yashab248/WIRELESS_RC_CAR/finalElectricalArchitecture.png

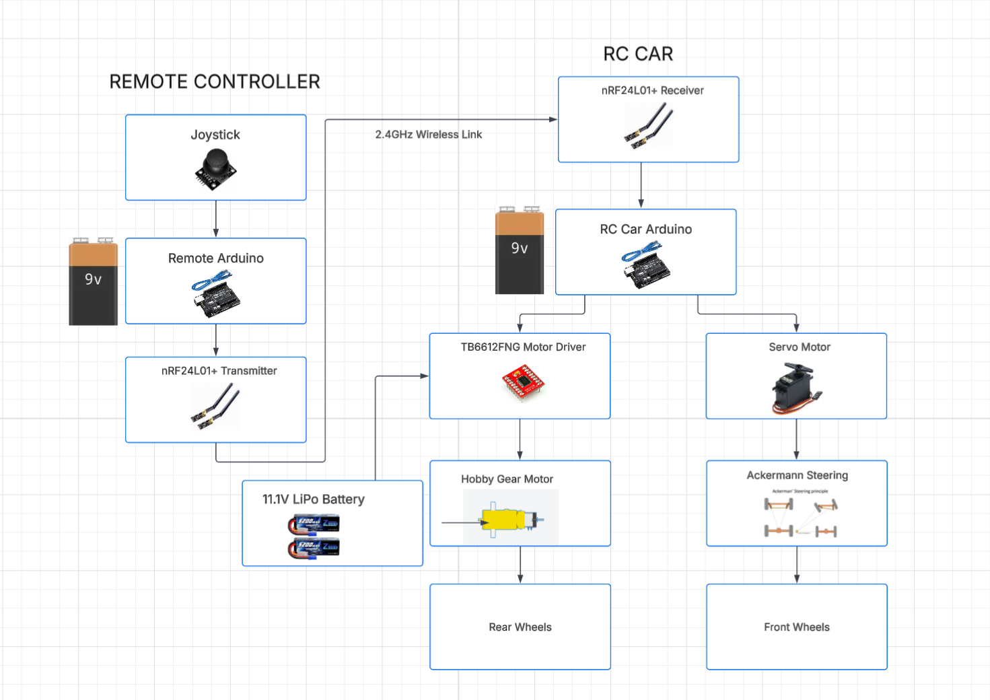
finalElectricalArchitecture.png
