yashab248/WIRELESS_RC_CAR/PROJECT-DEVELOPMENT-FLOWCHART.png

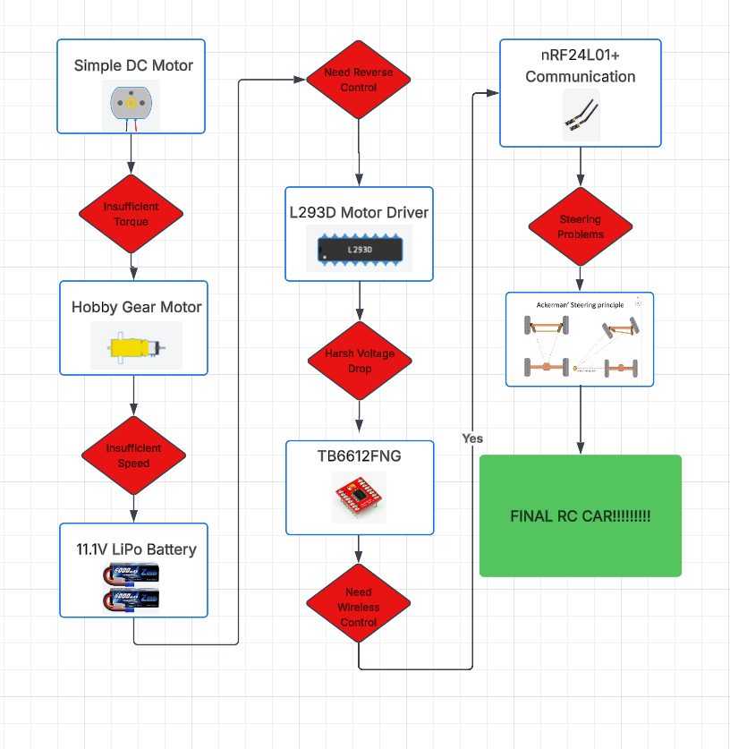
PROJECT-DEVELOPMENT-FLOWCHART.png
