yashab248/WIRELESS_RC_CAR/RC-CAR-L293D-CIRCUIT-SCHEMATIC.png

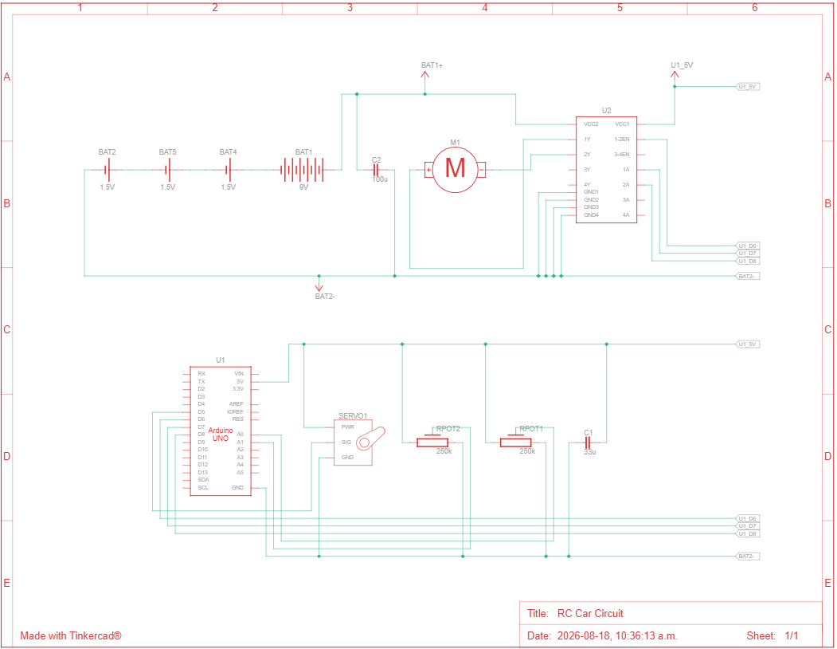
RC-CAR-L293D-CIRCUIT-SCHEMATIC.png
