yashab248/WIRELESS_RC_CAR/RC-CAR-L293D-CIRCUIT.png

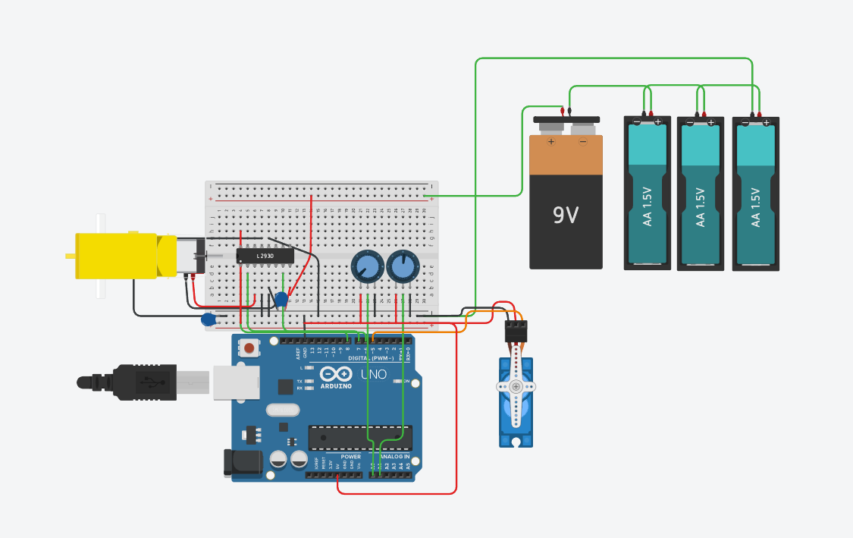
RC-CAR-L293D-CIRCUIT.png
