yashab248/WIRELESS_RC_CAR/RC-CAR-NPN-TRANSISTOR-CIRCUIT.png

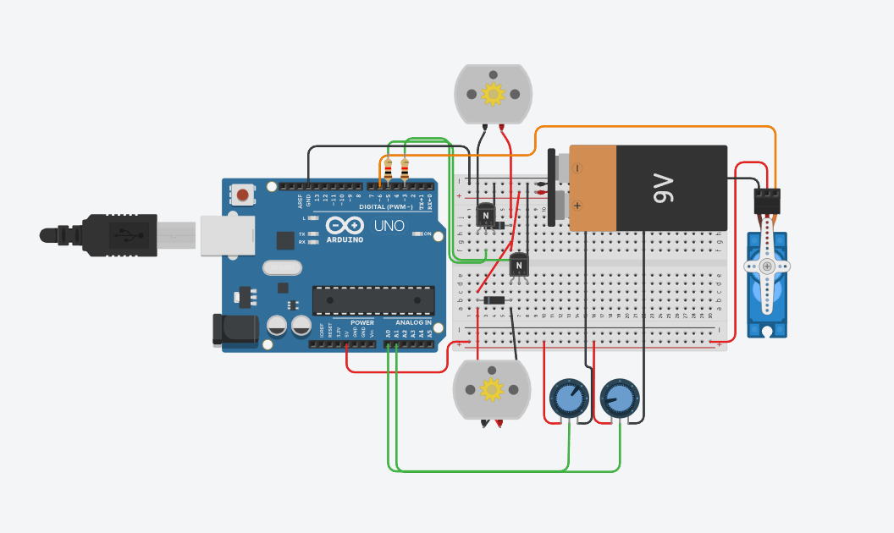
RC-CAR-NPN-TRANSISTOR-CIRCUIT.png
