yashab248/WIRELESS_RC_CAR/RC-CAR-NPN-TRANSISTOR-SCHEMATIC.png

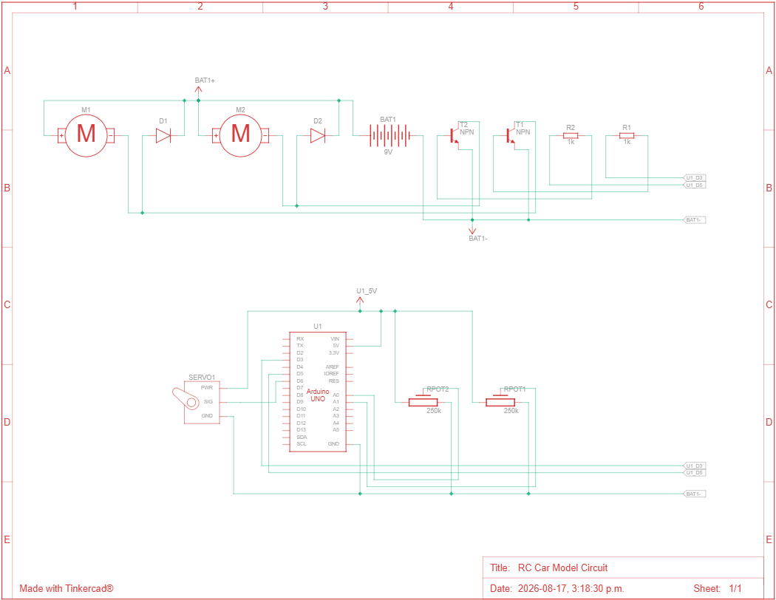
RC-CAR-NPN-TRANSISTOR-SCHEMATIC.png
