yashab248/WIRELESS_RC_CAR/RECEIVER-CIRCUIT-SCHEMATIC.png

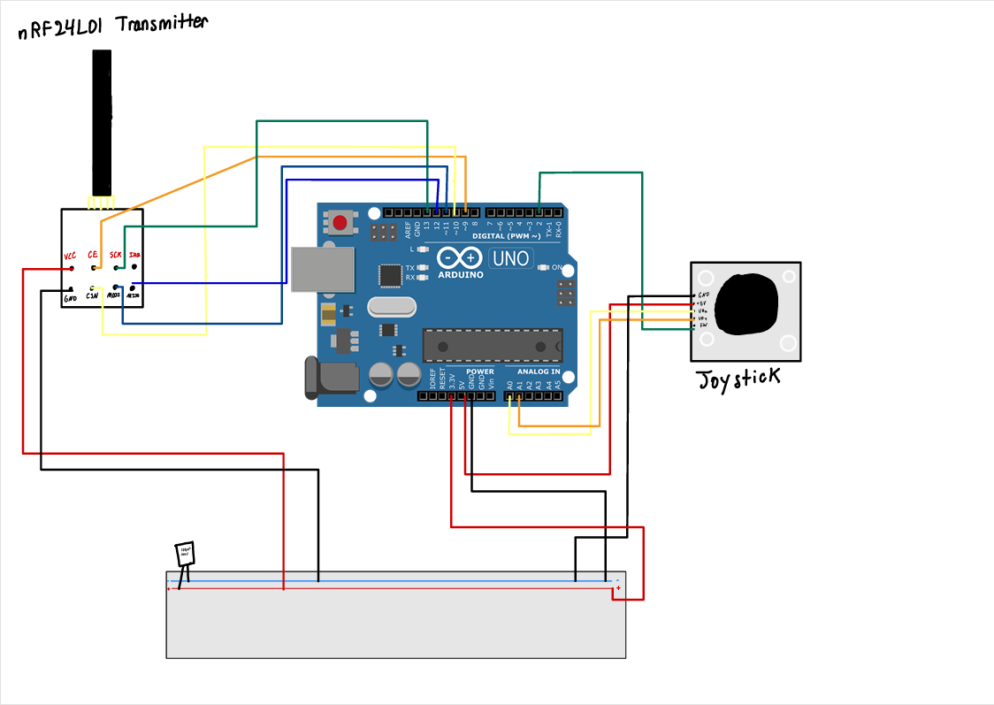
RECEIVER-CIRCUIT-SCHEMATIC.png
