yashab248/WIRELESS_RC_CAR/TRANSMITTER-CIRCUIT-SCHEMATIC.png

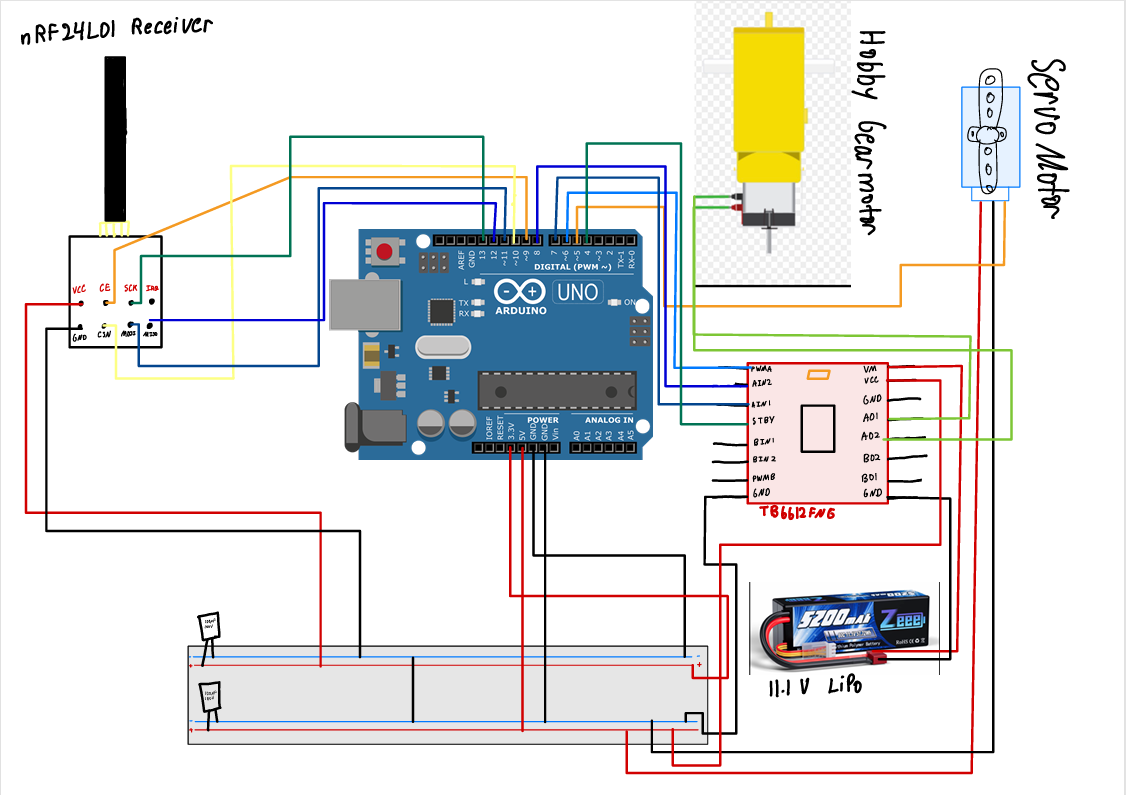
TRANSMITTER-CIRCUIT-SCHEMATIC.png
