yashab248/WIRELESS_RC_CAR/TRANSMITTER-FLOW-DIAGRAM.png

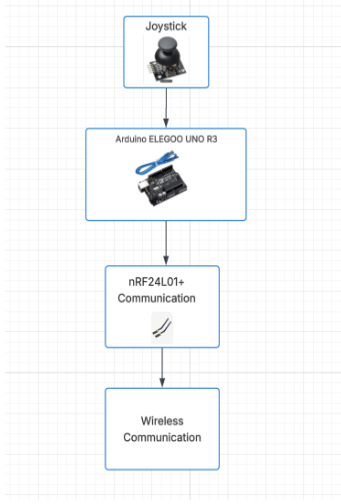
TRANSMITTER-FLOW-DIAGRAM.png
